AugetyYoYo/YoYo-Environmental-Monitor/docs/YoYo_环境简要素质检测仪_设计说明.md

# YoYo 环境简要素质检测仪 · 设计说明

> 本文给出硬件总体设计、电源架构、主控引脚分配、各外设总线与寄存器、RS485 协议等，作为软件与联调的接口依据。
> 配套：`..._BOM.md`（物料）、`..._踩坑记录.md`（调试经验）。

---

## 1. 系统概述

| 项目 | 内容 | 关键位号 |
|---|---|---|
| 主控 | STC8H8K64U-45I-LQFP48（8051 1T，64 KB Flash，8 KB xdata RAM，硬件 USB，12 位 ADC，4×UART/SPI/I²C/PWM；**本板 USB 走 CH340N，未用 MCU 原生 USB**） | U1 |
| 降压 | 12 V→5 V，5 A，500 kHz | U2 = RT8289GSP |
| LDO | 5 V→3.3 V，500 mA | LDO1 = ME6211C33M5G-N |
| ADC 基准 | 2.5 V 并联基准 | U4 = CJ431 |
| USB↔串口 | 调试/下载 | U3 = CH340N |
| RS485 | 半双工收发器 | U14 = MAX3485EESA+T |
| RTC | 实时时钟 + 32.768 kHz | U8 = PCF8563, X1 |
| 显示 | SPI OLED（8P 排针） | P1 |
| 传感器 | 温湿度 / CO₂ / 光照 / 气压 / 磁力计 | U13=SHT45, U5=SCD41, LED8=VEML7700, U7=BMP581, U12=IST8310 |
| 定位 | GPS/北斗（UART + IPEX 天线） | U6 = ATGM336H-F7N36, U9 |
| 颗粒物 | PMS7003（UART3） | U10 |
| 风速风向 / 噪声 | RS485 Modbus 外部传感器 | U14 |
| 存储 | TF 卡（SPI） | CARD1 |
| 人机 | 3 按键、蜂鸣器、状态 LED | SW3/4/5, BUZZER1, LED1~8 |
| 供电 | 3S 锂电（标称 11.1 V / 满电 12.6 V）/ 12.6 V 适配器；USB 5 V 并入 | DC1, CN1, SW1 |

板尺寸 75 × 75 mm，四角各一个 1.6 mm 半径圆孔。

---

## 2. 电源架构

```
 DC1 (12.6V 适配器) ─┐
                    ├─ SW1(源选择) ─► VCC_12V ─D1(SS54 防反)─► U2(RT8289) ─► VCC_5V ─► LDO1 ─H1(2P跳线)─► VCC_3V3
 CN1 (3S 锂电 11.1~12.6V)─┘                            (12V→5V, 5A)              (5V→3.3V, 500mA)
 USB-C VBUS ──D3(SS54)──────────────────────────────────────────────────────► VCC_5V
```

| 网络 | 电压 | 来源 | 主要负载 |
|---|---|---|---|
| `VCC_12V` | 11~12.6 V | DC1 / 电池（经 SW1） | **源侧**：EN 分压 R1、12 V 指示灯 LED1、电池 ADC 分压 R13、电源输出排针 H3.4 |
| U2 输入 | ≈VCC_12V−0.4 V | 经 **D1(SS54) 防反** | U2 的 VIN + 输入电容 |
| `VCC_5V` | 5 V（USB 时约 4.7 V） | U2 输出 或 USB(D3) | CH340(U3)、PMS7003、蜂鸣器、5 V 排针、LDO 输入 |
| `VCC_3V3` | 3.3 V | LDO1 经 **H1 跳线** | MCU、所有传感器、GPS、RS485、TF、OLED |

- **降压**：FB=1.222 V，R2=10k / R6=3.16k → 输出 **5.09 V**；自举电容 C4=100 nF。
- **EN 分压**：R1=10k / R5=3.16k → 输入 >5.8 V 时使能。
- **LDO**：VIN/CE 接 VCC_5V，VSS 接 GND，VOUT 经 H1 到 VCC_3V3（ME6211 输出侧需 ≥1 µF）。

> **防反灌（D1）**：USB 供电时降压芯片内部上管体二极管会把 5 V 反灌回 12 V 轨（抬到 ~4.5 V，导致 12 V 指示灯微亮、电池 ADC 读数被污染）。串入 D1(SS54) 后阻断。
> **断电下载（H1）**：`LDO1.VOUT → H1(2P) → VCC_3V3`。拔掉跳线帽即断 MCU/3.3 V 电，CH340 仍由 5 V 供电、串口不掉，便于 STC-ISP 冷启动下载。
> **LDO 发热**：ME6211 为 SOT-23-5，功耗 =(5−3.3)×I；200 mA 即 ~0.34 W、表面约 100 ℃，属正常范围。负载较大时可在 LDO 背面铺铜 + 打 GND 散热过孔，或改用 3.3 V buck。

### ADC 电池采样
- `ADC_VRef+` = 2.5 V（CJ431）；`ADC_BAT`(P0.1/ADC9) 测 `VCC_12V`，分压 R13=51k / R14=10k。
- `VCC_12V(mV) = ADC码 × 15250 / 4096`（12 位、左对齐）。
- 单次采样噪声较大，软件应做多次平均（实测平均后 12.0~12.1 V 稳定）。

---

## 3. 主控 STC8H8K64U 引脚分配（LQFP-48）

| 脚 | 端口 | 网络名 | 功能 | 备注 |
|---|---|---|---|---|
| 1 | P5.3 | OLED_ROM_CS | 字库片选 | 输出 |
| 2 | P0.5 | OLED_CS | OLED 片选 | 输出 |
| 3 | P0.6 | OLED_DC | OLED 数据/命令 | 输出 |
| 4 | P0.7 | GPS_ON/OFF | GPS 关断控制 | **高=工作，低=关断**；R27=10k 上拉 |
| 5 | P1.0/RxD2 | UART_GPS_RxD | GPS 串口接收 | 接 GPS TXD |
| 6 | P1.1/TxD2 | UART_GPS_TxD | GPS 串口发送 | 接 GPS RXD |
| 7 | P4.7 | GPS_1PPS | GPS 秒脉冲 | 输入（可中断） |
| 8 | P1.4/MISO | SPI_MISO | SPI 主机输入 | BMP581 SDO / TF DAT0（**建议 10k 上拉**） |
| 9 | P1.5/SCLK | SPI_CLK | SPI 时钟 | BMP581 SCK / TF CLK |
| 10 | P1.6 | TF_LED | TF 状态灯 | 三态（低=绿/高=红/高阻=灭） |
| 11 | P1.7 | GPS_LED | GPS 状态灯 | 三态 |
| 12 | P1.3/MOSI | SPI_MOSI | SPI 主机输出 | BMP581 SDI / TF CMD |
| 13 | UCap | — | USB 稳压电容 | 0.1 µF 到地 |
| 14 | NRST/P5.4 | NRST | 复位 | R8=10k 上拉 + C12=0.1 µF + SW2 |
| 15 | Vcc/AVcc | VCC_MCU | 电源 | 经 R9(0Ω) 接 VCC_3V3 |
| 16 | ADC_VRef+ | ADC_VRef+ | ADC 基准 | **2.5 V**（CJ431，R7=510Ω） |
| 17 | Gnd/AGnd | GND | 地 | |
| 18 | P4.0 | BMP_CS | BMP581 片选 | 输出 |
| 19 | P3.0/RxD | DEBUG_RXD | 下载/调试 RXD | 经 D4(1N5819) 接 CH340 TXD |
| 20 | P3.1/TxD | DEBUG_TXD | 下载/调试 TXD | 接 CH340 RXD |
| 21 | P3.2/INT0 | P3.2 | 扩展 H2-11 | 可中断 |
| 22 | P3.3/INT1 | P3.3 | 扩展 H2-12 | 可中断 |
| 23 | P3.4/PWM | PWM_BUZZER | 蜂鸣器 PWM | R15(1k)→Q1 |
| 24 | P5.0/RxD3_2 | UART_PMS_RxD | PMS 接收 | 接 PMS TX(pin9) |
| 25 | P5.1/TxD3_2 | UART_PMS_TxD | PMS 发送 | 接 PMS RX(pin7) |
| 26 | P3.5 | P3.5 | 扩展 H2-9 | |
| 27 | P3.6/INT2 | INT_RTC | RTC 中断 | PCF8563 INT#，R28=4.7k 上拉 |
| 28 | P3.7/INT3 | P3.7 | 扩展 H2-10 | 可中断 |
| 29 | P4.1 | PMS_RESET | PMS 复位 | R31=10k 上拉，低复位 |
| 30 | P4.2 | PMS_SET | PMS 设置 | R32=10k 上拉，高=工作/低=休眠 |
| 31 | P4.3/RxD_4 | P4.3 | 扩展 H2-7 | 可作 UART4 RX |
| 32 | P4.4/TxD_4 | P4.4 | 扩展 H2-8 | 可作 UART4 TX |
| 33 | P2.0 | P2.0 | 扩展 H2-5 | |
| 34 | P2.1 | P2.1 | 扩展 H2-6 | |
| 35 | P2.2 | P2.2 | 扩展 H2-3 | |
| 36 | P2.3 | P2.3 | 扩展 H2-4 | |
| 37 | P2.4/SDA | I2C_SDA | I²C 数据 | R25=4.7k 上拉 |
| 38 | P2.5/SCL | I2C_SCL | I²C 时钟 | R24=4.7k 上拉 |
| 39 | P2.6 | 485_RE&DE | RS485 收发控制 | **高=发送，低=接收**；R35=10k 下拉 |
| 40 | P2.7 | KEY_MODE | 按键 MODE | 内部上拉，按下接地 |
| 41 | P4.5 | — | 未使用 | 悬空 |
| 42 | P4.6 | KEY_UP | 按键 UP | 内部上拉，按下接地 |
| 43 | P0.0/ADC8 | KEY_DN | 按键 DN | 内部上拉，按下接地 |
| 44 | P0.1/ADC9 | ADC_BAT | 12 V/电池采样 | R13=51k / R14=10k 分压 |
| 45 | P0.2/RxD4 | UART_RS485_RxD | RS485 接收 | 接 U14 RO |
| 46 | P0.3/TxD4 | UART_RS485_TxD | RS485 发送 | 接 U14 DI |
| 47 | P0.4 | TF_CD | TF 卡检测 | 经 R26 接卡座 CD（**插卡=0**） |
| 48 | P5.2 | TF_CS | TF 卡片选 | 输出 |

---

## 4. 外设总线

### 4.1 I²C（SDA=P2.4，SCL=P2.5，R24/R25=4.7k 上拉）

| 器件 | 位号 | 7 位地址 | 说明 |
|---|---|---|---|
| SHT45 | U13 | **0x44** | 温湿度；T=−45+175·t/65535 ℃、RH=−6+125·rh/65535 % |
| SCD41 | U5 | **0x62** | CO₂；★须先发 `start_periodic_measurement(0x21B1)`，5 s 更新 |
| VEML7700 | LED8 | **0x10** | 环境光；★上电默认 shutdown，须先写 `ALS_CONF(0x00)=0x0000`；ALS 为 16 位寄存器 |
| IST8310 | U12 | **0x0C** | 三轴磁力计；★上电为 Stand-By，每次读前写 `CNTL1(0x0A)=0x01` 触发单次测量 |
| PCF8563 | U8 | **0x51** | RTC（BCD） |

### 4.2 SPI（MOSI=P1.3，MISO=P1.4，CLK=P1.5，四从机共用）

| 从机 | 位号 | CS | 备注 |
|---|---|---|---|
| BMP581（气压） | U7 | **P4.0** | 4 线 SPI；CHIP_ID 在 `0x01`=0x50、REV_ID `0x02`=0x32；读无需 dummy |
| TF 卡 | CARD1 | **P5.2** | 初始化用慢档、传输用快档；SDSC/SDHC 寻址不同 |
| OLED | P1 | **P0.5** | 另需 DC=P0.6 |
| 字库 | — | **P5.3** | GT20L16S1Y；★必须位翻转 SPI（详见踩坑记录） |

> MISO(P1.4) **无上拉**，空闲悬空，多器件并存时易抢线；建议飞线到 3.3 V 加 **10k 上拉**。

### 4.3 UART

| 接口 | 端口 | 引脚 | 波特率 | 说明 |
|---|---|---|---|---|
| 调试/下载 | UART1 (P3.0/P3.1) | 19/20 | 115200 | 经 U3=CH340N |
| GPS | UART2 (P1.0/P1.1) | 5/6 | **115200** | ATGM336H-F7N36，NMEA |
| PMS7003 | UART3 (P5.0/P5.1) | 24/25 | **9600**，8N1 | 固件用接收中断 + 环形缓冲收帧 |
| RS485 | UART4 (P0.2/P0.3) | 45/46 | **9600**，8N1 | U14=MAX3485，RE#/DE 由 P2.6 控制 |

---

## 5. 显示：OLED + 中文字库

- SSD1306 128×64，SPI；`CS=P0.5`、`DC=P0.6`。一行显示 4 行文本（页面 0/2/4/6）。
- 旋转 180°：初始化命令 `0xA0`（段重映射）+ `0xC0`（COM 扫描）一起设置。
- 中文字库 GT20L16S1Y（ROM_CS=P5.3），命令 `0x03` + 24 位地址：
  - 15×16 汉字 = `((区码−0xB0)*94 + (位码−0xA1) + 846)*32`
  - 8×16 ASCII = `(c−0x20)*16 + 0x3B7C0`
  - 点阵为"竖置横排"（列优先），低 bit=上方。

---

## 6. RS485 / Modbus（本机为主站）

总线 9600-8-N-1，本机为主站。**同一总线各从机地址必须唯一**（出厂默认均为 1，需先改）。

| 设备 | 地址 | 功能码 | 寄存器 |
|---|---|---|---|
| 环境噪声 | 1 | 0x03 | `0x0000` = 瞬时噪声 ×0.1 dB（量程 30~130 dB） |
| 风速 | 2 | 0x03 | `0x0000` = 风速 ×0.1 m/s、`0x0001` = 风级（0~60 m/s） |
| 风向 | 3 | 0x03 | `0x0000` = 角度 ×10（0~3599）、`0x0001` = 整数角度 |

- **修改地址**（广播帧，总线上只接要改的一台）：`FF 06 07 D0 00 <新地址> <CRC>`
- **修改波特率**（噪声/风速/风向**通用**）：`<当前地址或FF> 06 07 D1 00 <0=2400/1=4800/2=9600> <CRC>`（实测兆泰盛风速/风向也支持 0x07D1，不必用厂家工具）
- 风速/风向传感器线序：棕=电源正、黑=电源负、黄(绿)=485A、蓝=485B。

---

## 7. 下载与复位

- **无 SWD/JTAG**，只能串口 ISP。STC8H 需**冷启动**（上电瞬间）才能被 STC-ISP 抓到。
- 本板 USB 经 D3 直供 5 V，插着 USB 时 MCU 一直有电 —— 用 **H1 跳线**断 3.3 V 即可冷启动下载（CH340 不掉线）。
- **P5.4 复位脚**出厂默认是普通 I/O，复位键无效；需在 STC-ISP 里【取消勾选"复位脚用作 I/O 口"】并重新下载后，SW2 复位键才生效。

---

## 8. 连接器 / 排针

| 标识 | 类型 | 定义 |
|---|---|---|
| H1 | 2P | `1=VCC_3V3  2=LDO1.VOUT`（拔掉断 3.3 V，下载用） |
| H2 | 12P 扩展 | `GND / 3V3 / P2.2 / P2.3 / P2.0 / P2.1 / P4.3 / P4.4 / P3.5 / P3.7 / P3.2 / P3.3` |
| H3 | 4P 电源输出 | `1=GND  2=3V3  3=5V  4=12V` |
| H4 / H5 / H6 | 4P RS485（并联） | `1=GND  2=B  3=A  4=12V` |
| P1 | 8P OLED | `1=GND  2=3V3  3=CLK  4=MOSI  5=DC  6=CS  7=MISO  8=ROM_CS` |
| U10 | 10P PMS7003 排母 | `1/2=VCC  3/4=GND  5=RESET  7=RX  9=TX  10=SET` |
| CN1 / CN2 / DC1 / U9 / SW1 / SW2 | 电池 2P / GPS 备电 2P / DC 座 / IPEX / 源选择 / 复位 | |

---

## 9. 已知问题

- **MISO(P1.4) 无上拉**（悬空）：建议加 10k 拉高。
- **ADC 单次采样噪声偏大**：软件必须平均；硬件可考虑给 CJ431 基准并 1 µF+0.1 µF、P0.1 到 GND 加 1~10 nF。
- **SCD41**：传感器顶面白色 PTFE 保护膜**不可撕除**（撕后 CO₂ 通道永久失效）。
- 3S 电池组目前不带 BMS 保护板（后续升级再加）。
