AugetyYoYo/YoYo-Environmental-Monitor/docs/YoYo_环境简要素质检测仪_BOM.md

# YoYo 环境简要素质检测仪 · 物料清单（BOM）

> 已按「**相同参数统一为同一料号**」整理：同一阻值/容值/封装的器件只保留**一个**厂家型号。
> 料号列为立创商城（LCSC）编号，便于直接下单。数量为单板用量。

---

## 归并说明

原设计中若干**参数相同、厂家型号不同**的器件已统一（避免同参数多料号）：

| 参数 | 原多种料号 | 归并为 | 说明 |
|---|---|---|---|
| 100 nF 0603 | C14663 / C165958 / C5137636 | **C14663**（50 V） | 统一取 50 V 通用件 |
| 10 kΩ 0603 | C25804 / C559369 | **C25804** | 统一 |
| 47 µF 1206 | C403725(25 V) / C96123(10 V) | **C403725**（25 V） | 原 10 V 档在 12 V 轨上耐压不足，统一到 25 V |
| 3.16 kΩ 0603 | C22993 / C2930087 | **C22993** | 统一 |

---

## 1. 电阻（0603，±1%，1/10 W）

| 阻值 | 数量 | 位号 | 料号 | 型号 |
|---|---|---|---|---|
| 0 Ω | 1 | R9 | C21189 | 0603WAF0000T5E |
| 10 Ω | 1 | R30 | C2906983 | FRC0603F10R0TS |
| 120 Ω | 1 | R34 | C22787 | 0603WAF1200T5E |
| 220 Ω | 3 | R21, R22, R23 | C22962 | 0603WAF2200T5E |
| 470 Ω | 5 | R12, R17, R18, R19, R20 | C23179 | 0603WAF4700T5E |
| 510 Ω | 3 | R7, R33, R36 | C23193 | 0603WAF5100T5E |
| 1 kΩ | 2 | R3, R15 | C21190 | 0603WAF1001T5E |
| 3.16 kΩ | 2 | R5, R6 | C22993 | 0603WAF3161T5E |
| 3.3 kΩ | 1 | R4 | C22978 | 0603WAF3301T5E |
| 4.7 kΩ | 3 | R24, R25, R28 | C23162 | 0603WAF4701T5E |
| 5.1 kΩ | 2 | R10, R11 | C23186 | 0603WAF5101T5E |
| 10 kΩ | 11 | R1, R2, R8, R14, R16, R26, R27, R29, R31, R32, R35 | C25804 | 0603WAF1002T5E |
| 51 kΩ | 1 | R13 | C23196 | 0603WAF5102T5E |

**电阻合计：36 只**

## 2. 电容

| 参数 | 封装 | 数量 | 位号 | 料号 | 型号 |
|---|---|---|---|---|---|
| 12 pF ±5% 50 V | 0603 | 2 | C22, C25 | C38523 | CL10C120JB8NNNC |
| 100 nF ±10% 50 V | 0603 | 24 | C1, C4, C5, C8, C9, C11, C12, C13, C14, C15, C19, C20, C21, C23, C24, C26, C27, C29, C30, C32, C33, C34, C35, C36 | C14663 | CC0603KRX7R9BB104 |
| 1 µF ±10% 16 V | 0603 | 2 | C16, C17 | C106248 | CC0603KRX7R7BB105 |
| 4.7 µF ±10% 25 V | 0805 | 1 | C37 | C1779 | CL21A475KAQNNNE |
| 10 µF ±10% 25 V | 0805 | 4 | C2, C10, C28, C31 | C15850 | CL21A106KAYNNNE |
| 10 µF ±10% 10 V | 0603 | 1 | C18 | C19702 | CL10A106KP8NNNC |
| 47 µF ±20% 25 V | 1206 | 3 | C3, C6, C7 | C403725 | GRM31CR61E476ME44L |

**瓷片电容合计：37 只**

## 3. 二极管

| 器件 | 封装 | 数量 | 位号 | 料号 | 型号 |
|---|---|---|---|---|---|
| 肖特基 40 V/5 A | SMA | 3 | D1, D2, D3 | C22452 | SS54 |
| 肖特基 40 V/1 A | SOD-323 | 1 | D4 | C191023 | 1N5819WS |
| 开关二极管 | SOD-323 | 1 | D5 | C2128 | 1N4148WS |
| 双向 TVS 12 V | SMB | 1 | D6 | C19077566 | SMBJ12CA |

## 4. 电感 / 晶振 / 蜂鸣器

| 器件 | 封装 | 数量 | 位号 | 料号 | 型号 |
|---|---|---|---|---|---|
| 10 µH ±20% 5.5 A | SMD 7.3×6.8 | 1 | L1 | C167223 | FXL0630-100-M |
| 47 nH ±5% | 0603 | 1 | L2 | C29683 | SDCL1608C47NJTDF |
| 32.768 kHz ±20 ppm 12.5 pF | FC-135R | 1 | X1 | C32346 | Q13FC13500004 |
| 无源蜂鸣器 2.7 kHz | 8.5×8.5 | 1 | BUZZER1 | C94599 | MLT-8530 |

## 5. LED

| 器件 | 封装 | 数量 | 位号 | 料号 | 型号 |
|---|---|---|---|---|---|
| 绿色 LED | 0603 | 5 | LED1, LED2, LED3, LED6, LED7 | C7371898 | XL-1608UVC-04 |
| 红色 LED | 0603 | 2 | LED4, LED5 | C2286 | KT-0603R |

## 6. 集成电路 / 模块

| 位号 | 器件 | 封装 | 料号 |
|---|---|---|---|
| U1 | STC8H8K64U-45I | LQFP-48 | C3013145 |
| U2 | RT8289GSP（12V→5V 降压） | SOIC-8-EP | C39202 |
| U3 | CH340N（USB↔串口） | SOP-8 | C2977777 |
| U4 | CJ431（2.5 V 基准） | SOT-23-3 | C3113 |
| U5 | SCD41-D-R1（CO₂） | SMD | C3659362 |
| U6 | ATGM336H-5N31（GNSS；实装 F7N36） | SMD | C90770 |
| U7 | BMP581（气压） | LGA-10 | C5362283 |
| U8 | PCF8563（RTC） | SOP-8 | C5795601 |
| U9 | IPEX 天线座 | SMD 4P | C2987682 |
| U10 | 排母 2×5P 1.27 mm（PMS7003） | 2×5 | C54973807 |
| U11 | 钽电容 10 µF ±20% 10 V | 0805 | C1969735 |
| U12 | IST8310（磁力计） | LGA-16 | C2683055 |
| U13 | SHT45-AD1B-R2（温湿度） | DFN-4 | C5221601 |
| U14 | MAX3485EESA+T（RS485） | SOIC-8 | C9943 |
| LDO1 | ME6211C33M5G-N（5V→3.3V LDO） | SOT-23-5 | C82942 |
| LED8 | VEML7700-TR（环境光） | SMD 4P | C504893 |
| Q1 | S8050（蜂鸣器驱动） | SOT-23 | C2146 |
| CARD1 | TF-01A 卡座 | SMD | C91145 |

## 7. 开关 / 连接器

| 位号 | 器件 | 封装 | 料号 |
|---|---|---|---|
| SW1 | SS-12F44-G5 滑动开关（源选择） | 直插 | C136718 |
| SW2 | 轻触开关 6×6×6 mm 260 gf（复位） | SMD 4P | C2888580 |
| SW3, SW4, SW5 | 轻触开关 6×6×5 mm 立贴（按键） | SMD 4P | C2837531 |
| H1 | 1×2P 排针 2.54 mm（3.3 V 断电跳线） | 直插 | C492401 |
| H2 | 2×6P 排针 2.54 mm（扩展） | 直插 | C541855 |
| H3, H4, H5, H6 | 1×4P 排针 2.54 mm（电源 / RS485） | 直插 | C2718488 |
| P1 | 1×8P 排母 2.54 mm（OLED） | 直插 | C27438 |
| CN1 | XH2.54-2P（电池） | 直插 | C42391660 |
| CN2 | 1.25-2P 卧贴（GPS 备电） | SMD | C2845379 |
| DC1 | DC-005 电源座（内径 2.0 mm） | 直插 | C16214 |
| USB1 | Type-C 16P 母座 卧贴 | SMD | C709357 |

> 说明：SW2（复位）与 SW3~SW5（功能键）均为 6×6 轻触开关，但封装尺寸（LS8.6 vs LS9.0）不同，故保持两个料号；若统一封装，可合并为同一料号。
