AugetyYoYo/YoYo-Environmental-Monitor/firmware/MCU/STC8G_H_NVIC.h

/*---------------------------------------------------------------------*/
/* --- STC MCU Limited ------------------------------------------------*/
/* --- STC 1T Series MCU Demo Programme -------------------------------*/
/* --- Mobile: (86)13922805190 ----------------------------------------*/
/* --- Fax: 86-0513-55012956,55012947,55012969 ------------------------*/
/* --- Tel: 86-0513-55012928,55012929,55012966 ------------------------*/
/* --- Web: www.STCAI.com ---------------------------------------------*/
/* --- BBS: www.STCAIMCU.com  -----------------------------------------*/
/* --- QQ:  800003751 -------------------------------------------------*/
/* 如果要在程序中使用此代码,请在程序中注明使用了STC的资料及程序            */
/*---------------------------------------------------------------------*/

#ifndef	__STC8G_H_NVIC_H
#define	__STC8G_H_NVIC_H

#include	"config.h"

//========================================================================
//                              定义声明
//========================================================================

#define	FALLING_EDGE		1		//产生下降沿中断
#define	RISING_EDGE			2		//产生上升沿中断

//========================================================================
//                              定时器中断设置
//========================================================================

#define 	Timer0_Interrupt(n)		(n==0?(ET0 = 0):(ET0 = 1))				/* Timer0中断使能 */
#define 	Timer1_Interrupt(n)		(n==0?(ET1 = 0):(ET1 = 1))				/* Timer1中断使能 */
#define 	Timer2_Interrupt(n)		IE2 = (IE2 & ~0x04) | (n << 2)			/* Timer2中断使能 */
#define 	Timer3_Interrupt(n)		IE2 = (IE2 & ~0x20) | (n << 5)			/* Timer3中断使能 */
#define 	Timer4_Interrupt(n)		IE2 = (IE2 & ~0x40) | (n << 6)			/* Timer4中断使能 */

//========================================================================
//                             外部中断设置
//========================================================================

#define 	INT0_Interrupt(n)		(n==0?(EX0 = 0):(EX0 = 1))			/* INT0中断使能 */
#define 	INT1_Interrupt(n)		(n==0?(EX1 = 0):(EX1 = 1))			/* INT1中断使能 */
#define 	INT2_Interrupt(n)		INTCLKO = (INTCLKO & ~0x10) | (n << 4)	/* INT2中断使能 */
#define 	INT3_Interrupt(n)		INTCLKO = (INTCLKO & ~0x20) | (n << 5)	/* INT3中断使能 */
#define 	INT4_Interrupt(n)		INTCLKO = (INTCLKO & ~0x40) | (n << 6)	/* INT4中断使能 */

//========================================================================
//                              ADC中断设置
//========================================================================

#define 	ADC_Interrupt(n)		(n==0?(EADC = 0):(EADC = 1))	/* ADC中断控制 */

//========================================================================
//                              SPI中断设置
//========================================================================

#define 	SPI_Interrupt(n)		IE2 = (IE2 & ~0x02) | (n << 1)	/* SPI中断使能 */

//========================================================================
//                              I2C中断设置
//========================================================================

#define		I2C_Master_Inturrupt(n)	(n==0?(I2CMSCR &= ~0x80):(I2CMSCR |= 0x80))	//0：禁止 I2C 功能；1：使能 I2C 功能

//========================================================================
//                              UART中断设置
//========================================================================

#define		UART1_Interrupt(n)	(n==0?(ES = 0):(ES = 1))			/* UART1中断使能 */
#define		UART2_Interrupt(n)	IE2 = (IE2 & ~0x01) | (n)			/* UART2中断使能 */
#define		UART3_Interrupt(n)	IE2 = (IE2 & ~0x08) | (n << 3)		/* UART3中断使能 */
#define		UART4_Interrupt(n)	IE2 = (IE2 & ~0x10) | (n << 4)		/* UART4中断使能 */

//========================================================================
//                              RTC中断设置
//========================================================================

#define 	RTC_Interrupt(n)		RTCIEN = (n)		/* RTC中断使能 */

//========================================================================
//                            中断优先级定义
//========================================================================

//                                           7      6      5      4      3      2      1      0      Reset Value
//sfr IP2   = 0xB5; //                    PPWM2FD PI2C   PCMP    PX4  PPWM0FD  PPWM0  PSPI   PS2     0000,0000
#define		PUSB	0x80
#define		PPWM2FD	0x80
#define		PTKSU	0x80
#define		PI2C	0x40
#define		PCMP	0x20
#define		PX4		0x10
#define		PPWM0FD	0x08
#define		PPWMB	0x08
#define		PPWM0	0x04
#define		PPWMA	0x04
#define		PSPI	0x02
#define		PS2		0x01
//                                           7      6      5      4      3      2      1      0      Reset Value
//sfr IP2H  = 0xB6; //                    PPWM2FDH PI2CH PCMPH   PX4H PPWM0FDH PPWM0H PSPIH  PS2H    0000,0000
#define		PUSBH		0x80
#define		PPWM2FDH	0x80
#define		PTKSUH		0x80
#define		PI2CH		0x40
#define		PCMPH		0x20
#define		PX4H		0x10
#define		PPWM0FDH	0x08
#define		PPWMBH		0x08
#define		PPWM0H		0x04
#define		PPWMAH		0x04
#define		PSPIH		0x02
#define		PS2H		0x01

//串口2中断优先级控制
#define 	UART2_Priority(n)			do{if(n == 0) IP2H &= ~PS2H, IP2 &= ~PS2; \
																if(n == 1) IP2H &= ~PS2H, IP2 |= PS2; \
																if(n == 2) IP2H |= PS2H, IP2 &= ~PS2; \
																if(n == 3) IP2H |= PS2H, IP2 |= PS2; \
															}while(0)
//SPI中断优先级控制
#define 	SPI_Priority(n)				do{if(n == 0) IP2H &= ~PSPIH, IP2 &= ~PSPI; \
																if(n == 1) IP2H &= ~PSPIH, IP2 |= PSPI; \
																if(n == 2) IP2H |= PSPIH, IP2 &= ~PSPI; \
																if(n == 3) IP2H |= PSPIH, IP2 |= PSPI; \
															}while(0)
//外部中断4中断优先级控制
#define 	INT4_Priority(n)			do{if(n == 0) IP2H &= ~PX4H, IP2 &= ~PX4; \
																if(n == 1) IP2H &= ~PX4H, IP2 |= PX4; \
																if(n == 2) IP2H |= PX4H, IP2 &= ~PX4; \
																if(n == 3) IP2H |= PX4H, IP2 |= PX4; \
															}while(0)
//比较器中断优先级控制
#define 	CMP_Priority(n)				do{if(n == 0) IP2H &= ~PCMPH, IP2 &= ~PCMP; \
																if(n == 1) IP2H &= ~PCMPH, IP2 |= PCMP; \
																if(n == 2) IP2H |= PCMPH, IP2 &= ~PCMP; \
																if(n == 3) IP2H |= PCMPH, IP2 |= PCMP; \
															}while(0)
//I2C中断优先级控制
#define 	I2C_Priority(n)				do{if(n == 0) IP2H &= ~PI2CH, IP2 &= ~PI2C; \
																if(n == 1) IP2H &= ~PI2CH, IP2 |= PI2C; \
																if(n == 2) IP2H |= PI2CH, IP2 &= ~PI2C; \
																if(n == 3) IP2H |= PI2CH, IP2 |= PI2C; \
															}while(0)
//增强型PWM0中断优先级控制
#define 	PWM0_Priority(n)			do{if(n == 0) IP2H &= ~PPWM0H, IP2 &= ~PPWM0; \
																if(n == 1) IP2H &= ~PPWM0H, IP2 |= PPWM0; \
																if(n == 2) IP2H |= PPWM0H, IP2 &= ~PPWM0; \
																if(n == 3) IP2H |= PPWM0H, IP2 |= PPWM0; \
															}while(0)
//增强型PWM0异常检测中断优先级控制
#define 	PWM0FD_Priority(n)			do{if(n == 0) IP2H &= ~PPWM0FDH, IP2 &= ~PPWM0FD; \
																if(n == 1) IP2H &= ~PPWM0FDH, IP2 |= PPWM0FD; \
																if(n == 2) IP2H |= PPWM0FDH, IP2 &= ~PPWM0FD; \
																if(n == 3) IP2H |= PPWM0FDH, IP2 |= PPWM0FD; \
															}while(0)
//增强型PWM2异常检测中断优先级控制
#define 	PWM2FD_Priority(n)			do{if(n == 0) IP2H &= ~PPWM2FDH, IP2 &= ~PPWM2FD; \
																if(n == 1) IP2H &= ~PPWM2FDH, IP2 |= PPWM2FD; \
																if(n == 2) IP2H |= PPWM2FDH, IP2 &= ~PPWM2FD; \
																if(n == 3) IP2H |= PPWM2FDH, IP2 |= PPWM2FD; \
															}while(0)
//触摸按键中断优先级控制
#define 	PTKSU_Priority(n)			do{if(n == 0) IP2H &= ~PTKSUH, IP2 &= ~PTKSU; \
																if(n == 1) IP2H &= ~PTKSUH, IP2 |= PTKSU; \
																if(n == 2) IP2H |= PTKSUH, IP2 &= ~PTKSU; \
																if(n == 3) IP2H |= PTKSUH, IP2 |= PTKSU; \
															}while(0)

//USB中断优先级控制
#define 	USB_Priority(n)				do{if(n == 0) IP2H &= ~PUSBH, IP2 &= ~PUSB; \
																if(n == 1) IP2H &= ~PUSBH, IP2 |= PUSB; \
																if(n == 2) IP2H |= PUSBH, IP2 &= ~PUSB; \
																if(n == 3) IP2H |= PUSBH, IP2 |= PUSB; \
															}while(0)

//高级PWMA中断优先级控制
#define 	PWMA_Priority(n)			do{if(n == 0) IP2H &= ~PPWMAH, IP2 &= ~PPWMA; \
																if(n == 1) IP2H &= ~PPWMAH, IP2 |= PPWMA; \
																if(n == 2) IP2H |= PPWMAH, IP2 &= ~PPWMA; \
																if(n == 3) IP2H |= PPWMAH, IP2 |= PPWMA; \
															}while(0)

//高级PWMB中断优先级控制
#define 	PWMB_Priority(n)			do{if(n == 0) IP2H &= ~PPWMBH, IP2 &= ~PPWMB; \
																if(n == 1) IP2H &= ~PPWMBH, IP2 |= PPWMB; \
																if(n == 2) IP2H |= PPWMBH, IP2 &= ~PPWMB; \
																if(n == 3) IP2H |= PPWMBH, IP2 |= PPWMB; \
															}while(0)


//                                           7      6      5     4      3      2      1     0      Reset Value
//sfr IP3   = 0xDF; //                    PPWM4FD PPWM5  PPWM4  PPWM3  PPWM2  PPWM1  PS4   PS3     0000,0000
#define		PPWM4FD		0x80
#define		PPWM5		0x40
#define		PPWM4		0x20
#define		PPWM3		0x10
#define		PPWM2		0x08
#define		PPWM1		0x04
#define		PRTC		0x04
#define		PS4			0x02
#define		PS3			0x01
//                                           7        6       5      4       3       2     1     0      Reset Value
//sfr IP3H  = 0xEE; //                    PPWM4FDH PPWM5H  PPWM4H  PPWM3H  PPWM2H  PPWM1H PS4H  PS3H    0000,0000
#define		PPWM4FDH	0x80
#define		PPWM5H		0x40
#define		PPWM4H		0x20
#define		PPWM3H		0x10
#define		PPWM2H		0x08
#define		PPWM1H		0x04
#define		PRTCH		0x04
#define		PS4H		0x02
#define		PS3H		0x01

//RTC中断优先级控制
#define 	RTC_Priority(n)				do{if(n == 0) IP3H &= ~PRTCH, IP3 &= ~PRTC; \
																if(n == 1) IP3H &= ~PRTCH, IP3 |= PRTC; \
																if(n == 2) IP3H |= PRTCH, IP3 &= ~PRTC; \
																if(n == 3) IP3H |= PRTCH, IP3 |= PRTC; \
															}while(0)

//增强型PWM1中断优先级控制
#define 	PWM1_Priority(n)			do{if(n == 0) IP3H &= ~PPWM1H, IP3 &= ~PPWM1; \
																if(n == 1) IP3H &= ~PPWM1H, IP3 |= PPWM1; \
																if(n == 2) IP3H |= PPWM1H, IP3 &= ~PPWM1; \
																if(n == 3) IP3H |= PPWM1H, IP3 |= PPWM1; \
															}while(0)
//增强型PWM2中断优先级控制
#define 	PWM2_Priority(n)			do{if(n == 0) IP3H &= ~PPWM2H, IP3 &= ~PPWM2; \
																if(n == 1) IP3H &= ~PPWM2H, IP3 |= PPWM2; \
																if(n == 2) IP3H |= PPWM2H, IP3 &= ~PPWM2; \
																if(n == 3) IP3H |= PPWM2H, IP3 |= PPWM2; \
															}while(0)

//增强型PWM3中断优先级控制
#define 	PWM3_Priority(n)			do{if(n == 0) IP3H &= ~PPWM3H, IP3 &= ~PPWM3; \
																if(n == 1) IP3H &= ~PPWM3H, IP3 |= PPWM3; \
																if(n == 2) IP3H |= PPWM3H, IP3 &= ~PPWM3; \
																if(n == 3) IP3H |= PPWM3H, IP3 |= PPWM3; \
															}while(0)
//增强型PWM4中断优先级控制
#define 	PWM4_Priority(n)			do{if(n == 0) IP3H &= ~PPWM4H, IP3 &= ~PPWM4; \
																if(n == 1) IP3H &= ~PPWM4H, IP3 |= PPWM4; \
																if(n == 2) IP3H |= PPWM4H, IP3 &= ~PPWM4; \
																if(n == 3) IP3H |= PPWM4H, IP3 |= PPWM4; \
															}while(0)
//增强型PWM5中断优先级控制
#define 	PWM5_Priority(n)			do{if(n == 0) IP3H &= ~PPWM5H, IP3 &= ~PPWM5; \
																if(n == 1) IP3H &= ~PPWM5H, IP3 |= PPWM5; \
																if(n == 2) IP3H |= PPWM5H, IP3 &= ~PPWM5; \
																if(n == 3) IP3H |= PPWM5H, IP3 |= PPWM5; \
															}while(0)
//增强型PWM4异常检测中断优先级控制
#define 	PWM4FD_Priority(n)			do{if(n == 0) IP3H &= ~PPWM4FDH, IP3 &= ~PPWM4FD; \
																if(n == 1) IP3H &= ~PPWM4FDH, IP3 |= PPWM4FD; \
																if(n == 2) IP3H |= PPWM4FDH, IP3 &= ~PPWM4FD; \
																if(n == 3) IP3H |= PPWM4FDH, IP3 |= PPWM4FD; \
															}while(0)
//串口3中断优先级控制
#define 	UART3_Priority(n)			do{if(n == 0) IP3H &= ~PS3H, IP3 &= ~PS3; \
																if(n == 1) IP3H &= ~PS3H, IP3 |= PS3; \
																if(n == 2) IP3H |= PS3H, IP3 &= ~PS3; \
																if(n == 3) IP3H |= PS3H, IP3 |= PS3; \
															}while(0)
//串口4中断优先级控制
#define 	UART4_Priority(n)			do{if(n == 0) IP3H &= ~PS4H, IP3 &= ~PS4; \
																if(n == 1) IP3H &= ~PS4H, IP3 |= PS4; \
																if(n == 2) IP3H |= PS4H, IP3 &= ~PS4; \
																if(n == 3) IP3H |= PS4H, IP3 |= PS4; \
															}while(0)


//                                           7      6      5      4      3      2      1      0      Reset Value
//sfr IPH   = 0xB7; //中断优先级高位       PPCAH  PLVDH   PADCH   PSH   PT1H    PX1H   PT0H   PX0H    0000,0000
//#define		PPCAH	0x80
#define		PLVDH	0x40
#define		PADCH	0x20
#define		PSH		0x10
#define		PT1H	0x08
#define		PX1H	0x04
#define		PT0H	0x02
#define		PX0H	0x01

//外部中断0中断优先级控制
#define 	INT0_Priority(n)			do{if(n == 0) IPH &= ~PX0H, PX0 = 0; \
																if(n == 1) IPH &= ~PX0H, PX0 = 1; \
																if(n == 2) IPH |= PX0H, PX0 = 0; \
																if(n == 3) IPH |= PX0H, PX0 = 1; \
															}while(0)
//外部中断1中断优先级控制
#define 	INT1_Priority(n)			do{if(n == 0) IPH &= ~PX1H, PX1 = 0; \
																if(n == 1) IPH &= ~PX1H, PX1 = 1; \
																if(n == 2) IPH |= PX1H, PX1 = 0; \
																if(n == 3) IPH |= PX1H, PX1 = 1; \
															}while(0)
//定时器0中断优先级控制
#define 	Timer0_Priority(n)			do{if(n == 0) IPH &= ~PT0H, PT0 = 0; \
																if(n == 1) IPH &= ~PT0H, PT0 = 1; \
																if(n == 2) IPH |= PT0H, PT0 = 0; \
																if(n == 3) IPH |= PT0H, PT0 = 1; \
															}while(0)
//定时器1中断优先级控制
#define 	Timer1_Priority(n)			do{if(n == 0) IPH &= ~PT1H, PT1 = 0; \
																if(n == 1) IPH &= ~PT1H, PT1 = 1; \
																if(n == 2) IPH |= PT1H, PT1 = 0; \
																if(n == 3) IPH |= PT1H, PT1 = 1; \
															}while(0)
//串口1中断优先级控制
#define 	UART1_Priority(n)			do{if(n == 0) IPH &= ~PSH, PS = 0; \
																if(n == 1) IPH &= ~PSH, PS = 1; \
																if(n == 2) IPH |= PSH, PS = 0; \
																if(n == 3) IPH |= PSH, PS = 1; \
															}while(0)
//ADC中断优先级控制
#define 	ADC_Priority(n)				do{if(n == 0) IPH &= ~PADCH, PADC = 0; \
																if(n == 1) IPH &= ~PADCH, PADC = 1; \
																if(n == 2) IPH |= PADCH, PADC = 0; \
																if(n == 3) IPH |= PADCH, PADC = 1; \
															}while(0)
//低压检测中断优先级控制
#define 	LVD_Priority(n)				do{if(n == 0) IPH &= ~PLVDH, PADC = 0; \
																if(n == 1) IPH &= ~PLVDH, PADC = 1; \
																if(n == 2) IPH |= PLVDH, PADC = 0; \
																if(n == 3) IPH |= PLVDH, PADC = 1; \
															}while(0)
/*
//CCP/PCA/PWM中断优先级控制 - 放到"STC8G_PCA"文件
#define 	PCA_Priority(n)				do{if(n == 0) IPH &= ~PPCAH, PPCA = 0; \
																if(n == 1) IPH &= ~PPCAH, PPCA = 1; \
																if(n == 2) IPH |= PPCAH, PPCA = 0; \
																if(n == 3) IPH |= PPCAH, PPCA = 1; \
															}while(0)
*/

//========================================================================
//                           外部函数和变量声明
//========================================================================

u8 NVIC_Timer0_Init(u8 State, u8 Priority);
u8 NVIC_Timer1_Init(u8 State, u8 Priority);
u8 NVIC_Timer2_Init(u8 State, u8 Priority);
u8 NVIC_Timer3_Init(u8 State, u8 Priority);
u8 NVIC_Timer4_Init(u8 State, u8 Priority);
u8 NVIC_INT0_Init(u8 State, u8 Priority);
u8 NVIC_INT1_Init(u8 State, u8 Priority);
u8 NVIC_INT2_Init(u8 State, u8 Priority);
u8 NVIC_INT3_Init(u8 State, u8 Priority);
u8 NVIC_INT4_Init(u8 State, u8 Priority);
u8 NVIC_ADC_Init(u8 State, u8 Priority);
u8 NVIC_SPI_Init(u8 State, u8 Priority);
u8 NVIC_CMP_Init(u8 State, u8 Priority);
u8 NVIC_I2C_Init(u8 Mode, u8 State, u8 Priority);
u8 NVIC_UART1_Init(u8 State, u8 Priority);
u8 NVIC_UART2_Init(u8 State, u8 Priority);
u8 NVIC_UART3_Init(u8 State, u8 Priority);
u8 NVIC_UART4_Init(u8 State, u8 Priority);
u8 NVIC_PWM_Init(u8 Channel, u8 State, u8 Priority);
u8 NVIC_RTC_Init(u8 State, u8 Priority);
u8 NVIC_DMA_ADC_Init(u8 State, u8 Priority, u8 Bus_Priority);
u8 NVIC_DMA_M2M_Init(u8 State, u8 Priority, u8 Bus_Priority);
u8 NVIC_DMA_SPI_Init(u8 State, u8 Priority, u8 Bus_Priority);
u8 NVIC_DMA_LCM_Init(u8 State, u8 Priority, u8 Bus_Priority);
u8 NVIC_DMA_UART1_Tx_Init(u8 State, u8 Priority, u8 Bus_Priority);
u8 NVIC_DMA_UART1_Rx_Init(u8 State, u8 Priority, u8 Bus_Priority);
u8 NVIC_DMA_UART2_Tx_Init(u8 State, u8 Priority, u8 Bus_Priority);
u8 NVIC_DMA_UART2_Rx_Init(u8 State, u8 Priority, u8 Bus_Priority);
u8 NVIC_DMA_UART3_Tx_Init(u8 State, u8 Priority, u8 Bus_Priority);
u8 NVIC_DMA_UART3_Rx_Init(u8 State, u8 Priority, u8 Bus_Priority);
u8 NVIC_DMA_UART4_Tx_Init(u8 State, u8 Priority, u8 Bus_Priority);
u8 NVIC_DMA_UART4_Rx_Init(u8 State, u8 Priority, u8 Bus_Priority);
u8 NVIC_LCM_Init(u8 State, u8 Priority);

#endif
